ManmeetSingh122/FFBWheel/FFBWheel.ioc

Mcu.UserName=STM32F411CEUx
PA0-WKUP.Signal=ADCx_IN0
PA1.Signal=ADCx_IN1
PA11.Signal=USB_OTG_FS_DM
PA12.Signal=USB_OTG_FS_DP
PA2.Signal=ADCx_IN2
PA3.Signal=ADCx_IN3
PA4.Signal=ADCx_IN4
PA5.Signal=ADCx_IN5
PA8.Signal=S_TIM1_CH1
PA9.Signal=S_TIM1_CH2
PC13-ANTI_TAMP.Signal=GPIO_Output
