ManmeetSingh122/FFBWheel/Core/Src/config.c

#include "config.h"
#include "motor.h"
#include "failsafe.h"
#include "stm32f4xx_hal.h"
#include <string.h>

WheelConfig_t g_cfg;

/* ── Factory defaults ────────────────────────────────────────────────────── */
void Config_Defaults(void)
{
    memset(&g_cfg, 0, sizeof(WheelConfig_t));
    g_cfg.magic           = CONFIG_MAGIC;

    /* Wheel */
    g_cfg.wheel_range     = DEFAULT_WHEEL_RANGE;
    g_cfg.pulley_ratio    = DEFAULT_PULLEY_RATIO;
    g_cfg.pot_degrees     = DEFAULT_POT_DEGREES;
    g_cfg.steer_invert    = 0;
    g_cfg.steer_center    = ADC_MAX / 2;
    g_cfg.steer_min       = 0;
    g_cfg.steer_max       = ADC_MAX;

    /* Input source */
    g_cfg.input_mode      = INPUT_MODE_POT;
    g_cfg.encoder_ppr     = DEFAULT_ENCODER_PPR;

    /* FFB */
    g_cfg.ffb_strength    = DEFAULT_FFB_STRENGTH;
    g_cfg.spring_gain     = DEFAULT_SPRING_GAIN;
    g_cfg.damper_gain     = DEFAULT_DAMPER_GAIN;
    g_cfg.friction_gain   = DEFAULT_FRICTION_GAIN;
    g_cfg.inertia_gain    = DEFAULT_INERTIA_GAIN;
    g_cfg.max_torque      = DEFAULT_MAX_TORQUE;

    /* Advanced FFB */
    g_cfg.filter_strength   = DEFAULT_FILTER_STRENGTH;
    g_cfg.bumpstop_strength = DEFAULT_BUMPSTOP_STRENGTH;
    g_cfg.center_spring     = DEFAULT_CENTER_SPRING;
    g_cfg.torque_smooth     = DEFAULT_TORQUE_SMOOTH;

    /* Misc */
    g_cfg.center_deadzone = DEFAULT_CENTER_DEADZONE;

    /* Pedals */
    g_cfg.thr_min    = 0;   g_cfg.thr_max    = ADC_MAX;
    g_cfg.brake_min  = 0;   g_cfg.brake_max  = ADC_MAX;
    g_cfg.clutch_min = 0;   g_cfg.clutch_max = ADC_MAX;
    g_cfg.thr_curve    = 1;   /* linear */
    g_cfg.brake_curve  = 2;   /* square for brake feel */
    g_cfg.clutch_curve = 1;

    /* Default 5-point curves: linear (0,25,50,75,100) */
    for (uint8_t i = 0; i < CURVE_POINTS; i++) {
        uint8_t v = (uint8_t)(i * 25);
        g_cfg.thr_pts[i]    = v;
        g_cfg.brake_pts[i]  = v;
        g_cfg.clutch_pts[i] = v;
    }

    /* Shifter */
    g_cfg.shft_x_left  = 1365;
    g_cfg.shft_x_right = 2730;
    g_cfg.shft_y_fwd   = 2730;
    g_cfg.shft_y_rev   = 1365;
}

/* ── Load from flash ─────────────────────────────────────────────────────── */
void Config_Load(void)
{
    const WheelConfig_t *flash = (const WheelConfig_t*)CONFIG_FLASH_ADDR;

    if (flash->magic == CONFIG_MAGIC && flash->wheel_range != 0xFFFF) {
        memcpy(&g_cfg, flash, sizeof(WheelConfig_t));
    } else {
        Config_Defaults();
    }
}

/* ── Save to flash ───────────────────────────────────────────────────────── */
uint8_t Config_Save(void)
{
    HAL_StatusTypeDef status;

    Motor_Stop();
    Failsafe_KickWDT();

    if (HAL_FLASH_Unlock() != HAL_OK) return 0;

    FLASH_EraseInitTypeDef erase = {0};
    erase.TypeErase    = FLASH_TYPEERASE_SECTORS;
    erase.VoltageRange = FLASH_VOLTAGE_RANGE_3;
    erase.Sector       = FLASH_SECTOR_7;
    erase.NbSectors    = 1;
    uint32_t sector_error = 0;
    status = HAL_FLASHEx_Erase(&erase, &sector_error);
    if (status != HAL_OK || sector_error != 0xFFFFFFFFU) {
        HAL_FLASH_Lock();
        return 0;
    }

    uint32_t addr  = CONFIG_FLASH_ADDR;
    uint32_t *src  = (uint32_t*)&g_cfg;
    uint32_t words = (sizeof(WheelConfig_t) + 3) / 4;

    for (uint32_t i = 0; i < words; i++) {
        status = HAL_FLASH_Program(FLASH_TYPEPROGRAM_WORD, addr, src[i]);
        if (status != HAL_OK) {
            HAL_FLASH_Lock();
            return 0;
        }
        addr += 4;
    }

    HAL_FLASH_Lock();
    return 1;
}
