ManmeetSingh122/FFBWheel/(commit log)

2026-04-27 Revise README for STM32F411 and flashing steps
    Updated README to reflect changes in the microcontroller model and clarified flashing instructions.
2026-04-28 nstructions for files update
    Updated instructions for flashing and configuring the STM32 board to include information about downloading files from Releases.
2026-05-03 V2.5 - Encoder support, active bumpstop, center spring, torque smoothing, 5-point curves, configurable filter
